SSSSSmilewei/lab-safety-monitor/labguard/tests/test_backend.py

"""
后端离线测试：协议、串口链路、状态机、视觉时序逻辑。
不需要摄像头、模型或真实下位机。运行：
    python tests/test_backend.py
"""
import os
import sys
import time
import struct
import tempfile

ROOT = os.path.dirname(os.path.dirname(os.path.abspath(__file__)))
for p in (ROOT, os.path.join(ROOT, "LabSafetyMonitor"), os.path.join(ROOT, "tests")):
    sys.path.insert(0, p)

from src import config as config_mod

config_mod.load()
_cfg = config_mod._config
_tmp = tempfile.mkdtemp(prefix="labsafety_test_")
_cfg["events"]["db"] = os.path.join(_tmp, "events.db")
_cfg["events"]["snapshot_dir"] = os.path.join(_tmp, "snaps")
_cfg["rules"]["unattended_heating_cut_s"] = 1.0
_cfg["rules"]["sim_latch_release_s"] = 0.5
_cfg["rules"]["item_hold_s"] = 0.0   # 测试里器皿逐步切换，不需要防抖
_cfg["events"]["retrigger_s"] = 0.0   # 测试里事件快速开关，不需要防抖
_cfg["presence"]["absent_seconds"] = 0.5
_cfg["presence"]["recover_seconds"] = 0.2
_cfg["voting"]["window_s"] = 0.5
_cfg["voting"]["min_frames"] = 3
_cfg["sleep"]["still_seconds"] = 0.5
_cfg["notify"]["webhook_url"] = ""
_cfg["serial"]["engine_stale_s"] = 1.0   # 安全判断停止 1 秒后停发心跳

try:
    from PySide6.QtCore import QCoreApplication
except ImportError:
    from PyQt6.QtCore import QCoreApplication

import numpy as np
import serial_comm
from serial_comm import SerialComm, build_frame, FrameParser, crc16_ccitt, MSG_TELEMETRY
from fake_mcu import FakeMCU
from src.core.telemetry import telemetry
from src.core.events import events
from src.core.state_machine import SafetyStateMachine

app = QCoreApplication.instance() or QCoreApplication(sys.argv)
PASSED = []


def check(cond, name):
    if not cond:
        raise AssertionError(name)
    PASSED.append(name)
    print(f"  ✔ {name}")


def wait_until(pred, timeout=3.0):
    t0 = time.time()
    while time.time() - t0 < timeout:
        if pred():
            return True
        time.sleep(0.02)
    return False


# ---------------------------------------------------------------------------
print("[1] 帧协议")
check(crc16_ccitt(b"123456789") == 0x29B1, "CRC16-CCITT 标准校验值 0x29B1")
f1 = build_frame(1, MSG_TELEMETRY, struct.pack("<hHhHBB", 251, 553, 300, 400, 0x3F, 0))
f2 = build_frame(2, 0x11, bytes([7, 2, 0]))
bad = bytearray(build_frame(3, 0x11, bytes([1, 2, 0])))
bad[-1] ^= 0xFF
stream = b"\x00\xAA\x13garbage" + f1 + bytes(bad) + f2
p = FrameParser()
got = []
for i in range(0, len(stream), 3):      # 模拟串口分片到达
    got += p.feed(stream[i:i + 3])
check([g[1] for g in got] == [MSG_TELEMETRY, 0x11], "噪声 + 分片 + CRC 错误帧后仍能正确解出两帧")
check(p.crc_errors == 1, "CRC 错误帧被丢弃并计数")

# ---------------------------------------------------------------------------
print("[2] 演示模式（无下位机）：兜底规则 + 自动解锁")
SerialComm._shared = None
sm = SafetyStateMachine(serial_controller=None)
alerts = []
sm.alert_triggered.connect(lambda d: alerts.append(d))
telemetry.update("ipc", temp=68.0, humi=35.0, obj_temp=None, smoke=None)
state, _ = sm.evaluate(["Beaker"], True, 68.0, 35.0)
check(state == "CRITICAL" and sm.latched, "器皿 + 无人值守 + 环境 68℃ → CRITICAL 并锁定")
check(alerts and "演示模式" in alerts[-1]["message"], "演示模式下如实说明是软件模拟断电")
check(events.is_active("power_latched"), "事件中心记录断电锁定")
telemetry.update("ipc", temp=25.0, humi=55.0, obj_temp=None, smoke=None)
state, _ = sm.evaluate(["Beaker"], True, 25.0, 55.0)
check(state == "CRITICAL", "危险刚解除时仍保持锁定")
time.sleep(0.6)
sm.evaluate(["Beaker"], True, 25.0, 55.0)
state, _ = sm.evaluate(["Beaker"], True, 25.0, 55.0)
check(state == "NORMAL" and not sm.latched, "危险解除 0.5 秒后自动解锁")
state, _ = sm.evaluate(["Volumetric flask"], True, 68.0, 35.0)
check(state == "WARNING" and not sm.latched, "容量瓶不算可加热器皿，不触发兜底断电（只有环境高温告警）")

# ---------------------------------------------------------------------------
print("[3] 串口未连接时，断电如实报告失败")
link_down = SerialComm(port="COM_NOT_EXIST")
SerialComm._shared = link_down
link_down.port_setting = "COM_NOT_EXIST"
check(link_down.send_power_off() is False and link_down.power_off_state == "failed_no_link",
      "send_power_off() 返回 False，不再假装成功")

# ---------------------------------------------------------------------------
print("[4] 仿真下位机：干烧断电 → ACK → 锁定 → 现场复位")
SerialComm._shared = None
mcu = FakeMCU()
link = SerialComm(port="FAKE")


def fake_open(self=link):
    self.serial_conn = mcu
    self.port = "FAKE"
    self._notify("link_up", {"port": "FAKE"})
    return True


link._try_open = fake_open
link.connect()
check(wait_until(lambda: link.is_alive), "链路建立，收到遥测")
time.sleep(0.3)
check(mcu.last_hb == 0, "安全判断还没运行时不发心跳")

sm = SafetyStateMachine(serial_controller=link)
alerts.clear()
sm.alert_triggered.connect(lambda d: alerts.append(d))


def push_hw():
    d = link.get_sensor_data()
    telemetry.update("hardware", temp=d["temp"], humi=d["humi"], obj_temp=d["obj_temp"], smoke=d["smoke"])
    return d


mcu.obj_temp = 30.0
time.sleep(0.2)
push_hw()
state, _ = sm.evaluate(["Beaker"], False, 25.0, 55.0)
check(state == "NORMAL", "热源 30℃ 正常")
check(wait_until(lambda: mcu.last_hb > 0), "安全判断运行后，下位机收到心跳")

mcu.obj_temp = 130.0
wait_until(lambda: link.get_sensor_data()["obj_temp"] == 130.0)
push_hw()
state, _ = sm.evaluate(["Beaker"], False, 25.0, 55.0)
check(state == "CRITICAL" and sm.latched, "热源 130℃ ≥ 120℃ → 干烧 CRITICAL")
check(alerts[-1]["event_type"] == "HIGH_RISK_DRY_BURN" and "等待下位机确认" in alerts[-1]["message"],
      "告警说明'已下发，等待确认'，而不是直接宣称成功")
check(wait_until(lambda: link.power_off_state == "acked"), "下位机 ACK 确认断电")
check(wait_until(lambda: link.get_sensor_data()["latched"]), "遥测显示下位机已锁定、继电器断开")
check(wait_until(lambda: mcu.alert_level == 2), "心跳携带红灯等级")

mcu.obj_temp = 30.0
wait_until(lambda: link.get_sensor_data()["obj_temp"] == 30.0)
push_hw()
state, _ = sm.evaluate(["Beaker"], False, 25.0, 55.0)
check(state == "CRITICAL", "温度恢复后仍保持锁定（等待现场复位）")

mcu.press_reset()
wait_until(lambda: not link.get_sensor_data()["latched"])
time.sleep(0.15)
push_hw()
sm.evaluate(["Beaker"], False, 25.0, 55.0)
state, _ = sm.evaluate(["Beaker"], False, 25.0, 55.0)
check(state == "NORMAL" and not sm.latched, "现场按复位键后解除锁定")
check(wait_until(lambda: mcu.alert_level == 0), "解除后恢复绿灯")

# ---------------------------------------------------------------------------
print("[5] 加热中无人值守：先警告，超时后断电")
mcu.obj_temp = 70.0
wait_until(lambda: link.get_sensor_data()["obj_temp"] == 70.0)
push_hw()
state, _ = sm.evaluate(["Beaker"], True, 25.0, 55.0)
check(state == "WARNING" and not sm.latched, "加热 70℃ + 无人 → WARNING（倒计时）")
time.sleep(1.1)
push_hw()
state, _ = sm.evaluate(["Beaker"], True, 25.0, 55.0)
check(state == "CRITICAL" and sm.latched, "持续超过 cut_s → 断电")
mcu.obj_temp = 30.0
mcu.press_reset()
wait_until(lambda: not link.get_sensor_data()["latched"])
time.sleep(0.15)
push_hw()
sm.evaluate([], False, 25.0, 55.0)

# ---------------------------------------------------------------------------
print("[6] 下位机本地超温自主断电 → 上位机同步锁定")
mcu.obj_temp = 160.0
check(wait_until(lambda: link.get_sensor_data()["latched"]), "下位机本地规则断电")
push_hw()
state, _ = sm.evaluate([], False, 25.0, 55.0)
check(state == "CRITICAL" and sm.latched, "上位机同步为锁定状态")
mcu.obj_temp = 30.0
mcu.press_reset()
wait_until(lambda: not link.get_sensor_data()["latched"])
time.sleep(0.15)
push_hw()
sm.evaluate([], False, 25.0, 55.0)
check(not sm.latched, "复位后解除")

# ---------------------------------------------------------------------------
print("[6b] 心跳由安全判断驱动")
sm.evaluate([], False, 25.0, 55.0)
time.sleep(1.3)
hb = mcu.last_hb
time.sleep(1.2)
check(mcu.last_hb == hb, "安全判断停止后心跳停发（下位机看门狗可以接管）")
sm.evaluate([], False, 25.0, 55.0)
check(wait_until(lambda: mcu.last_hb > hb), "安全判断恢复后心跳恢复")

# ---------------------------------------------------------------------------
print("[6c] 断电后不算加热；复位门槛与上位机一致")
mcu.obj_temp = 130.0
wait_until(lambda: link.get_sensor_data()["obj_temp"] == 130.0)
push_hw()
sm.evaluate([], False, 25.0, 55.0)
check(wait_until(lambda: link.get_sensor_data()["latched"]), "130℃ 断电，继电器断开")
mcu.obj_temp = 70.0
wait_until(lambda: link.get_sensor_data()["obj_temp"] == 70.0)
push_hw()
sm.evaluate(["Beaker"], True, 25.0, 55.0)
check(not events.is_active("unattended_heating"), "继电器已断开时，70℃ + 无人不再报加热无人")
mcu.obj_temp = 125.0
wait_until(lambda: link.get_sensor_data()["obj_temp"] == 125.0)
mcu.press_reset()
time.sleep(0.3)
check(link.get_sensor_data()["latched"], "125℃（高于上位机干烧阈值）时复位被拒绝，不会先通电再被断电")
mcu.obj_temp = 30.0
mcu.press_reset()
check(wait_until(lambda: not link.get_sensor_data()["latched"]), "降到 30℃ 后复位成功")
time.sleep(0.15)
push_hw()
sm.evaluate([], False, 25.0, 55.0)
sm.evaluate([], False, 25.0, 55.0)
check(not sm.latched, "上位机同步解除锁定")

# ---------------------------------------------------------------------------
print("[6c2] 控制键：通电中长按 2 秒现场断电，再长按 2 秒复位")
mcu.press_button()
check(wait_until(lambda: link.get_sensor_data()["latched"] and link.get_sensor_data()["cut_reason"] == 5),
      "通电中长按控制键 → 下位机断电锁定，原因码 5")
time.sleep(0.15)
push_hw()
sm.evaluate([], True, 25.0, 55.0)
check(sm.latched and "现场按键断电" in sm.latch_reason, "上位机同步锁定，原因显示为现场按键断电")
check(any("现场按键断电" in s for s in events.recent_lines(5)), "按键断电事件记入日志")
mcu.press_button()
check(wait_until(lambda: not link.get_sensor_data()["latched"]), "已断电时再长按 → 复位上电")
time.sleep(0.15)
push_hw()
sm.evaluate([], True, 25.0, 55.0)
check(not sm.latched, "上位机随之解除锁定")

# ---------------------------------------------------------------------------
print("[6d] 温湿度传感器掉线：不用旧数据，如实提醒")
mcu.temp, mcu.humi = None, None
check(wait_until(lambda: link.get_sensor_data()["temp"] is None), "遥测上报温湿度无效")
d = push_hw()
state, _ = sm.evaluate([], False, d["temp"], d["humi"])
check(events.is_active("env_sensor_fault") and not sm.latched, "提示温湿度传感器无数据，不断电")
mcu.temp, mcu.humi = 25.0, 55.0
wait_until(lambda: link.get_sensor_data()["temp"] == 25.0)
d = push_hw()
sm.evaluate([], False, d["temp"], d["humi"])
check(not events.is_active("env_sensor_fault"), "传感器恢复后提醒解除")

# ---------------------------------------------------------------------------
print("[7] 下位机不回 ACK：断电失败如实上报，并持续重发")
mcu.drop_acks = True
mcu.obj_temp = 130.0
wait_until(lambda: link.get_sensor_data()["obj_temp"] == 130.0)
push_hw()
sm.evaluate([], False, 25.0, 55.0)
check(wait_until(lambda: link.power_off_state == "failed_no_ack", 2.0), "3 次未收到 ACK → failed_no_ack")
check(any("断电指令未确认" in line for line in events.recent_lines(20)), "事件日志提示人工断电")
mcu.drop_acks = False
link.disconnect()
check(not link.is_open, "主动断开")

# ---------------------------------------------------------------------------
print("[8] 视觉时序逻辑（假模型）")
import dual_inference as di


class Box:
    def __init__(self, cls, conf, xyxy):
        self.cls, self.conf, self.xyxy = [cls], [conf], [xyxy]


class Res:
    def __init__(self, boxes):
        self.boxes = boxes


class FakeModel:
    def __init__(self, names):
        self.names = names
        self.boxes = []

    def __call__(self, *a, **k):
        return [Res(list(self.boxes))]


SerialComm._shared = None
sysd = di.DualInferenceSystem()
ppe_names = {0: "Drinking", 1: "Eating", 2: "Gloves", 3: "Googles", 4: "Head Mask", 5: "Lab Coat",
             6: "Mask", 7: "No Gloves", 8: "No Head Mask", 9: "No Lab coat", 10: "No Mask", 11: "No googles"}
chem_names = {0: "Beaker", 12: "Volumetric flask"}
sysd.ppe_model, sysd.ppe_class_names = FakeModel(ppe_names), ppe_names
sysd.chem_model, sysd.chem_class_names = FakeModel(chem_names), chem_names
sysd.vision_ok = True
f = np.zeros((480, 640, 3), np.uint8)
meta = {"pano_valid": True, "desk_valid": True, "simulated": False}


def step(n=1, dt=0.05):
    out = None
    for _ in range(n):
        sysd._process(f, f, meta, time.time(), 20.0)
        out = sysd.get_results()
        time.sleep(dt)
    return out


sysd.ppe_model.boxes = [Box(5, 0.9, (100, 100, 300, 400)), Box(3, 0.8, (180, 110, 230, 140))]
r = step(3)
check(r[2]["unattended"] is False, "只检测到实验服 + 护目镜（没有口罩）也算'有人'")
sysd.ppe_model.boxes = []
step(1)
r = step(12)
check(r[2]["unattended"] is True, "连续 absent_seconds 无人员装备 → 无人值守")
sysd.ppe_model.boxes = [Box(5, 0.9, (100, 100, 300, 400))]
r = step(6)
check(r[2]["unattended"] is False, "人员回来 recover_seconds 后解除")

sysd.ppe_model.boxes = [Box(5, 0.9, (100, 100, 300, 400)), Box(11, 0.7, (180, 110, 230, 140))]
r = step(2)
check(not r[2]["ppe_violation"], "单帧/少量帧的'未戴护目镜'不立即报警（投票防抖）")
r = step(10)
check(r[2]["ppe_violation"] and "未佩戴护目镜" in r[3], "持续出现 → 确认违规")
check(events.is_active("ppe_goggles"), "事件中心记录违规")
sysd.ppe_model.boxes = [Box(5, 0.9, (100, 100, 300, 400)), Box(3, 0.8, (180, 110, 230, 140))]
r = step(14)
check(not r[2]["ppe_violation"] and not events.is_active("ppe_goggles"), "纠正后自动解除")

sysd.chem_model.boxes = [Box(0, 0.9, (300, 300, 360, 470))]       # 底部 y=470 → 0.979，越过桌边线 0.92
r = step(10)
check(r[2]["falling_warning"], "器皿越过/靠近桌边线 → 坠落风险")
sysd.chem_model.boxes = [Box(0, 0.9, (300, 100, 360, 200))]
r = step(14)
check(not r[2]["falling_warning"] and r[2]["chem_items"] == ["Beaker"], "器皿在台面内侧 → 无风险")

# 台面安全区：自己框的多边形 + 危险边（只有危险边附近才算靠近桌边）
from src.core import desk_zone as dz
Z = dz.validate_zone({"points": [[0.1, 0.1], [0.9, 0.1], [0.9, 0.9], [0.1, 0.9]], "danger": [False, False, True, False]})
check(dz.zone_clearance(0.5, 0.5, Z) > 0.3, "安全区中央离危险边很远")
check(0 < dz.zone_clearance(0.5, 0.86, Z) < 0.06, "靠近危险边（下边）→ 进入预警带")
check(dz.zone_clearance(0.5, 0.95, Z) < 0, "越过危险边 → 负距离")
check(dz.zone_clearance(0.95, 0.5, Z) == dz.FAR and dz.zone_clearance(0.12, 0.5, Z) > 0.3, "靠近 / 越过安全边不预警")
for bad, why in (({"points": [[0, 0], [1, 1], [1, 0], [0, 1]]}, "边交叉"), ({"points": [[0, 0], [0.05, 0], [0, 0.05]]}, "面积过小"),
                 ({"points": [[0, 0], [1, 0], [1, 1]], "danger": [False] * 3}, "没有危险边"), ({"points": [[0, 0], [2, 0], [1, 1]]}, "超出画面")):
    try:
        dz.validate_zone(bad); check(False, "安全区校验：" + why)
    except dz.ZoneError:
        check(True, "安全区校验拒绝：" + why)
check(dz.validate_zone({"points": []}) is None, "空顶点 = 清除安全区")
_cfg["desk"]["zone"] = Z
sysd.chem_model.boxes = [Box(0, 0.9, (300, 300, 360, 412))]       # 底部 0.858 → 靠近下边（危险边）
r = step(10)
check(r[2]["falling_warning"], "安全区：器皿靠近危险边 → 坠落风险")
sysd.chem_model.boxes = [Box(0, 0.9, (590, 200, 630, 300))]       # 越过右边（安全边）
r = step(14)
check(not r[2]["falling_warning"], "安全区：越过安全边（靠墙一侧）不报警")
_cfg["desk"]["zone"] = None

sysd.ppe_model.boxes = [Box(5, 0.9, (100, 200, 300, 470)), Box(6, 0.8, (180, 380, 230, 420))]
r = step(14)
check(r[2]["sleeping"], "面部装备持续偏低且静止 → 疑似伏案")

sysd.enable_ppe = False
sysd.ppe_model.boxes = []
r = step(15)
check(r[2]["unattended"] is False, "关闭人员模型时不判定无人值守（旧版会误判）")
r = step(1)
check("====== 最近事件 ======" in r[6], "日志文本包含最近事件，不会被每帧覆盖丢失")

# ---------------------------------------------------------------------------
print("[9] 交叉验证（人员 × 器皿 × 传感器 → 三级风险）")
from src.core import cross_check as cc
from src.core.tunable import validate as tv
r = cc.assess({"person_present": True, "chem_items": []})
check(r["level"] == "low" and r["light"] == 0 and r["score"] == 0, "无风险因素 → 低危绿灯")
r = cc.assess({"person_present": True, "ppe_missing": ["ppe_goggles"], "chem_items": []})
check(r["level"] == "low" and r["score"] == 8, "只看一路：没戴护目镜但台面空、未加热 → 仍是低危（提醒）")
r = cc.assess({"person_present": True, "ppe_missing": ["ppe_goggles"], "heating": True,
               "chem_items": ["Beaker", "Measuring Cylinder"], "wm_phase": "heating"})
check(r["level"] == "mid" and r["score"] == 65 and r["light"] == 1, "加热 × 量筒 × 未戴护目镜 → 中危 65（黄灯）")
check({f["source"] for f in r["factors"]} == {"器皿 × 传感器", "人员 × 传感器"}, "依据标明交叉来源")
r = cc.assess({"person_present": False, "heating": True, "chem_items": ["Beaker"]})
check(r["level"] == "high" and r["light"] == 2, "加热中台前无人 → 高危（红灯）")
r = cc.assess({"person_present": True, "eating": True, "chem_items": ["Reagent Bottle"]})
check(r["level"] == "mid" and r["score"] == 60, "台面有试剂 × 饮食 → 中危")
r = cc.assess({"person_present": True, "eating": True, "chem_items": []})
check(r["level"] == "low" and r["score"] == 25, "单独饮食（无试剂、未加热）→ 低危")
r = cc.assess({"latched": True})
check(r["level"] == "high" and r["score"] == 100, "断电锁定中 → 高危")
r = cc.assess({"person_present": False, "heating": True, "sleeping": True, "eating": True, "chem_items": ["Reagent Bottle"],
               "event_levels": ["CRITICAL"]})
check(r["score"] == 100, "风险分封顶 100")
r = cc.assess({"person_present": True, "ppe_missing": ["ppe_goggles"], "heating": True,
               "chem_items": ["Beaker", "Measuring Cylinder"], "wm_phase": "heating"}, mid_score=20, high_score=60)
check(r["level"] == "high" and r["thresholds"] == {"mid": 20, "high": 60}, "分界可配置：高危阈值调到 60 → 同一工况升为高危")
ok, err = tv({"cross.mid_score": 50, "cross.high_score": 55}, {})
check("cross.high_score" in err and not ok, "高危分界必须比中危高 10 分以上")
ok, err = tv({"cross.high_score": 80}, {"cross.mid_score": 30})
check(ok == {"cross.high_score": 80} and not err, "合法分界通过校验")

print("[10] 分层上报（学生端 / 实验室 / 实验楼）")
lv = lambda r: tuple(r["tiers"][k]["level"] for k in ("student", "teacher", "building"))
r = cc.assess({"person_present": True, "eating": True, "ppe_missing": ["ppe_goggles", "ppe_mask", "ppe_headmask"],
               "event_levels": ["WARNING", "NOTICE"], "hazard_levels": []})
check(lv(r) == ("high", "low", "low") and r["tiers"]["teacher"]["action"] == "仅记录",
      "摘防护吃东西：学生端高危，实验室只记录，实验楼不打扰")
check("实验区饮食" in r["tiers"]["teacher"]["notes"], "行为违规在实验室层记为知会")
r = cc.assess({"person_present": True, "ppe_missing": ["ppe_goggles"], "heating": True,
               "chem_items": ["Beaker", "Measuring Cylinder"], "wm_phase": "heating", "hazard_levels": ["NOTICE"]})
check(lv(r) == ("mid", "mid", "low"), "加热时放量筒：学生端、实验室中危，实验楼不打扰")
r = cc.assess({"person_present": True, "heating": True, "chem_items": ["Beaker"], "wm_phase": "overheat",
               "wm_risk": 0.7, "event_levels": ["WARNING"], "hazard_levels": ["WARNING"]})
check(lv(r) == ("high", "high", "mid") and r["tiers"]["building"]["action"] == "关注", "快烧干：实验室立即处置，实验楼关注")
r = cc.assess({"latched": True, "event_levels": ["CRITICAL"], "hazard_levels": ["CRITICAL"]})
check(lv(r) == ("high", "high", "high") and r["tiers"]["building"]["action"] == "需介入", "断电锁定：三层均为最高")
r = cc.assess({"person_present": True, "called": True, "hazard_levels": []})
check(lv(r) == ("low", "mid", "low"), "学生呼叫教师：实验室层升为中危")
r = cc.assess({"person_present": True, "eating": True, "event_levels": ["WARNING"]})
check(r["tiers"]["teacher"]["level"] == "mid", "未提供 hazard_levels 时退回 event_levels（兼容旧调用）")

print(f"\n全部通过：{len(PASSED)} 项")
