SSSSSmilewei/lab-safety-monitor/(commit log)

2026-10-18 部署脚本适配视美泰 AIOT-3588A
    - setup.sh：支持 LABGUARD_CONDA_DIR，把 conda 装到大分区（AIOT-3588A 系统盘只剩不到 1GB，用 /userdata）
    - setup.sh：librknnrt 为 1.x 时备份后换成 2.x，与 pip 装的 rknn-toolkit-lite2 2.x 匹配；先下载到 /tmp，失败则还原
    - start.sh：查找 conda 环境时增加 $LABGUARD_CONDA_DIR 和 /userdata/miniforge3
2026-10-18 适配视美泰 AIOT-3588A：导出 RKNN 模型，统一 NPU 版本为 2.3.2
    - 新增 models/*_rknn_model（rknn-toolkit2 2.3.2，FP16），模拟器中与原模型结果一致
    - export_rknn.py：固定 toolkit 版本、检查 numpy<2、导出后在模拟器里对比，删除中间 onnx
    - 新增 tools/check_npu.py：板子上检查芯片识别、三处版本、模型加载、速度、与 .pt 对比
    - dual_inference：只在 Rockchip 板子上用 RKNN；NPU 加载失败自动改用 .pt 并记事件
    - setup.sh：conda 默认装到 /userdata（可用 LABGUARD_CONDA_DIR 指定），pip 缓存不占系统盘；
    rknn-toolkit-lite2 与 librknnrt.so 固定 2.3.2，版本不对时先备份 .bak、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
2026-10-18 修复开发板上网页大屏启动失败：补回被 rknnlite 改掉的日志级别名
    rknn-toolkit-lite2 2.3.2 导入时会把 logging 的级别名换成 C/E/W/I/D，
    uvicorn 配置日志时报 "Unknown level: 'INFO'"，程序在 AIOT-3588A 上启动即退出。
    启动 uvicorn 前补回标准级别名。板子上已验证：程序正常启动，两个模型走 NPU，
    test_backend 41 项、test_platform 39 项全部通过。
2026-10-19 web_url.txt 写入带口令的完整网址，复制整行即可登录
    Claude-Session: https://claude.ai/code/session_01RBEqRs9tmreLCwQMrgxup9
2026-10-23 修复心跳/旧数据等 6 个问题；新增交叉验证、总后台后端（账号权限、实验室树、阈值预设、语音）初版
    半成品：总后台前端、Dashboard、字体替换尚未完成。
    [config.yaml]
2026-10-23 新增台面安全区：现场框选台面多边形并标注危险边，替代固定桌边线
    - src/core/desk_zone.py：多边形校验（顶点数、交叉、面积、至少一条危险边）与有向距离计算
    - dual_inference：器皿靠近桌边改按安全区判断，画面上画出危险边 / 安全边
    - 网页「参数 → 台面安全区」：拖动顶点、单击边中点切换危险边、双击插入 / 删除顶点、预警距离
    - PUT /api/desk/zone；未框选时沿用 desk.edge_line
    - 补测试：后端 63 项、平台 44 项全部通过；AGENTS.md 同步，文案约定改为正式用语
    - 一并提交总后台入口 run_center.py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
2026-10-23 修复 .gitignore：行尾注释导致 local_private/ 实际未被忽略
2026-10-23 总后台：按账号保留旧版 Zpix 像素风格（默认仍为新字体）；新增总后台测试 39 项
    - users.ui_style（standard / pixel），旧数据库自动补字段
    - PATCH /api/me/prefs 切换本账号风格；管理员可在 PATCH /api/users/{id} 为他人设置
    - GET /font/zpix.ttf 供像素风格加载
    - tests/test_center.py：登录改密锁定、混合粒度授权、终端上报与指令、按区域阈值、界面风格
2026-10-23 总后台网页前端：总览、实验桌、阈值配置、模型看板、语音、区域与终端、账号与授权
    - 按设计稿规范实现：3px 墨色描边 + 硬阴影、风险色条与标签、自绘线条图标（与设计稿同源）
    - 字体本地化 labguard/fonts（得意黑、JetBrains Mono，SIL OFL），断网可用；按账号可切换旧版 Zpix 像素风格
    - 原生 JS 无构建：center/static/core.js（请求、登录改密、路由、个人设置）+ views/*.js
    - tools/center_demo.py：示例楼栋与账号 + 模拟 11 台终端上报，用于演示与调试
    - 浏览器实测：各页面无脚本错误；教师授权范围、阈值保存与越界拒绝、远程断电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
2026-10-23 交叉验证中危 / 高危分界可按区域配置（cross.mid_score / high_score），补交叉验证测试
    - assess() 接收分界参数并在结果里返回；高危须比中危高 10 分以上
    - 进入远程可调白名单：开发板网页、总后台按区域下发都可改
    - 总后台实验桌页风险条刻度按实际分界绘制
    - 测试：后端 75 项（新增交叉验证 12 项）、平台 44 项、总后台 41 项全部通过
2026-10-23 开发板本机控制台换新样式（布局不变），保留旧版像素风格开关；补 websockets 依赖
    - 墨色硬边、得意黑标题、等宽数字、线条图标；事件卡改为左侧色条
    - 页签栏右侧「像素风格」按钮 / ?ui=pixel：恢复旧版靛蓝描边 + Zpix，记在本浏览器
    - 标题「总后台」改为「本机控制台」，与多实验室总后台区分
    - requirements.txt 补 websockets：缺少时 uvicorn 不支持 WebSocket，网页一直显示「重连中」
    - 修复系统日志等级标签被挤成两行
2026-10-23 实验台小屏换新样式并新增「待处理事项」；交叉验证依据附带处置动作
    - cross_check：每条依据增加 action（给台前同学的动作），量器名称改为中文
    - 小屏状态页：左侧待处理事项（按风险着色，加热中提示离岗断电时限）、中间热源、右侧防护与环境
    - ui.style：standard（墨色硬边 + 得意黑标题 + 等宽数字，默认）/ pixel（旧版 Zpix 与靛蓝描边）
    - 断电整屏接管改为分步恢复指引；页签与按钮文案改为正式用语
    - fonts 增加 Qt 用的 SmileySans-Oblique.otf、JetBrainsMono-Bold.ttf；电脑大窗口保持旧版
    - 离屏渲染核对中危 / 低危 / 断电三种状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
2026-10-23 AGENTS.md：更新当前状态（总后台、交叉验证、台面安全区）
2026-10-23 总后台：补开发板 CenterLink 经真实 HTTP 接入的测试（上报、阈值与硬上限、指令回写、语音包），本机联调通过
2026-10-23 固件：控制键长按 2 秒按状态切换（通电中 = 现场断电并锁定，已断电 = 复位上电）；新增断电原因 5 / 事件码 8，上位机与仿真下位机同步
2026-10-23 总后台：实验桌状态新增平面图视图（楼层 → 房间 → 实验桌，位置可在区域页设置）；实验桌演示画面上传与回落显示；演示脚本改为三层楼示意布局 + 演示账号
2026-10-23 固件：蜂鸣器改为非阻塞（移植自 fix/firmware-ack-before-beep），避免断电提示音拖慢 ACK 被误判为无应答；注明 N8R8 编译参数
    [lab_guard_esp32.ino]
2026-10-23 依赖：固定 CPU 版 torch，限制 opencv / contourpy 版本避开 numpy 2（移植自 fix/firmware-ack-before-beep）
2026-10-23 演示脚本新增 --live：指定终端不模拟，生成带节点密钥的配置供真实开发板程序接入（实时画面）；headless 模式不再因 PySide6 版本拒绝启动
2026-10-23 重写 README（系统组成、总后台、终端接入、演示、开发板部署、固件烧录、测试）；终端上报实际监听端口（端口被占用顺延时总后台仍能取到画面）；固件编译输出不入库
2026-10-23 撤回 headless 跳过 PySide6 版本检查：识别线程每帧经 Qt 信号跨线程传 dict，6.12 + Python 3.10 下 headless 同样会因引用计数错误崩溃（本机实测 free(): invalid size）
2026-10-23 分层上报：学生端 / 实验室老师 / 实验楼三层各自计算风险等级
    - cross_check.tiers()：学生端沿用原等级；实验室老师层只算加热、温度预测、烟雾、断电锁定与「呼叫教师」，饮食、防护等行为违规只记为知会；实验楼层只看断电锁定与紧急事件，实验室高危时标关注
    - engine 传入安全规则事件等级与呼叫教师时间（cross.call_hold_s）；群消息默认不推行为事件（notify.skip_behavior）
    - 总后台：/api/overview?tier=，管理员默认实验楼视角、教师默认实验室视角，可切换；实验桌详情列出三层等级；模型看板加分层规则表；旧版终端无分层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
    [config.yaml, test_backend.py]
2026-10-23 功能落地：干净初始化脚本、呼叫教师接入总后台、模拟温湿度不冒充实测、开机自启加载 API Key、网页背景动画
    - tools/center_init.py：一张实验桌 + 一台终端 + 一个教师账号，无模拟数据；已有数据时拒绝执行
    - 呼叫教师：终端快照带 call，总后台处置队列置顶「求助」，老师「已知晓」（call_ack，只在总后台记录）
    - 没接控制盒时总后台实验桌页、小屏不显示模拟温湿度，标「控制盒未接入」
    - start.sh 加载仓库外的 ~/.config/labguard/env（大模型 API Key），开机自启也能用远程线路
    - 本机控制台与总后台网页恢复 45° 斜向点阵 + 流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
2026-10-24 答辩网页演示：6 章 16 拍，信号灯圆点贯穿全场（slides/web/）
    浅色舞台 + 玻璃面板，1920×1080 等比缩放；模型曲线取自 model_card.json，三层视角平面图取自 center_demo 演示场景；N 提词、F 全屏，断网可用。
    Claude-Session: https://claude.ai/code/session_01SLZXaqJ1fYjc6mG1cxSJjE
2026-10-24 答辩演示重构：新增「工程实现」章（关键代码、协议、测试、实物照片位），去 AI 味与术语修订；新增 PowerPoint 版
    - 网页版 slides/web/：7 章 22 拍；蓝图网格底，玻璃只留给实物元素，代码统一深色代码块；术语改为 mAP@0.5、NPU 单帧推理、ACK 往返时延中位数、交叉验证注明为多源规则打分等；照片放入 img/photo-1..3.jpg 自动替换占位
    - PowerPoint 版 slides/实验室安全答辩.pptx：pptxgenjs 生成（slides/pptx/build.js），原生折线图，每页备注提词，照片页为可「更改图片」的占位图
    Claude-Session: http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
2026-10-24 答辩演示：换思源宋体 / 更纱黑体，三处示意图换成实机截图，修正事实与措辞
    - 标题思源宋体、正文更纱黑体（本机未装时用 Noto CJK 子集）
    - 学生是第一用户、安全助手、只断不通三页改用 docs/上手指南图片 的实机截图
    - 训练曲线按 dataviz 校验换配色，标出 best.pt 所在轮次，加悬停数值
    - 助手工具数 4→5；ACK 改为最多发送 3 次；看门狗条件补全为热源 >60℃；删去未核实的 CRC 计数说法
    - 去掉中点分隔和 PPT 元数据里的校名
    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
2026-10-24 答辩演示按工程视角重构：每页落到具体模块和代码（24 页）
    - 需求页改成「缺口 → 工程约束 → 落点」；系统组成、调用链前移到需求章
    - 识别章新增类别映射表、RKNN→ONNX→.pt 加载回退与 put_latest；投票页补人员在场判断
    - 面向学生章：吃苹果演示配事件链与曲目号；三级风险配 assess() 打分代码和逐项分数；新增规则 R1–R9 与温度预测拟合页；助手页改为 TOOLS 代码
    - 断电单独成章；总后台章新增终端上报协议、阈值硬上限复核
    - PPT 同步重排，备注与网页提词一致
    Claude-Session: ht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
2026-10-24 新版系统设计说明书 V2.0：按当前仓库重写七篇内容，沿用旧版排版
    - 七篇各自另起一页；封面去掉学校与个人信息，文档属性已清空
    - 内容对应当前代码：ESP32-S3 固件硬规则与心跳看门狗、AA 55 + CRC16 + ACK 协议、规则 R1–R9、温度预测、交叉验证与三层上报、安全助手、小屏、本机控制台、总后台
    - 架构、数据流、时序、部署与事件流转配图；界面篇使用实机截图
    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
2026-11-10 README: 去掉比赛相关内容，改为双语（英文 + 简体中文）
    Claude-Session: https://claude.ai/code/session_016ZfyJUXm39dqHPfPAQgQjb
